cshastry/Mechatronics/RC Car/IMG_3042.jpg

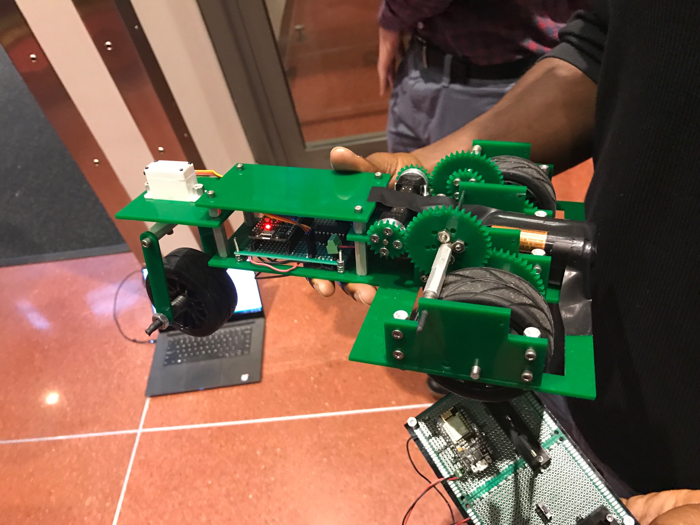
RC Car/IMG_3042.jpg
