cshastry/Mechatronics/RC Car/IMG-20171113-WA0011.jpg

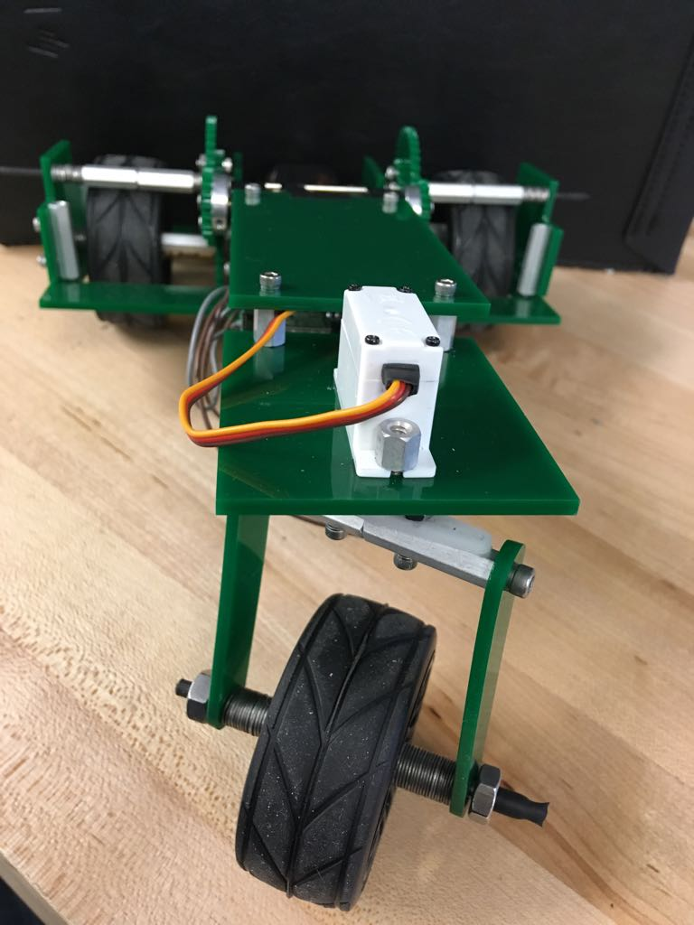
RC Car/IMG-20171113-WA0011.jpg
