cshastry/Mechatronics/README.md

# Mechatronics
Video available on request
